AllenXu-weihao/PLFM_RADAR/(commit log)

2026-04-22 chore(fpga): untrack TB-generated CSV, ignore a.out
    rx_final_doppler_out.csv is written by tb_radar_receiver_final.v on
    every run via $fopen — it is a test-run artifact, not an oracle. It
    was mistakenly tracked in an earlier commit, causing unnecessary
    churn on every sim. Remove from the index and ignore going forward.
    Also ignore stray a.out from iverilog one-shot compiles.
    Golden references (.hex, .mem, doppler_golden_py_*.csv) remain
    tracked — they are load-bearing oracles used by MF / Doppler /
    receiver cosim testbenches.
    [rx_final_doppler_out.csv]
2026-04-23 fix(radar): RX chain corrections, GUI bin alignment, MCU boot ordering
    FPGA — RX chain
    matched_filter_multi_segment.v: drop the gratuitous /4 scaling on
    DDC sign-extended input (was ddc_i[17:2] + ddc_i[1]); use
    ddc_i[15:0] directly. fft_engine has INTERNAL_W=32 with
    saturating 16-bit output, so full 16-bit input is safe. Restores
    ~12 dB of MF input dynamic range.
    radar_receiver_final.v: remove latency_buffer (count-N-pulses-then-
    prime FIFO that left frame 1 with all-zero ref). Replaced with
    a single-FF alignment register on ref_i/ref_q that matches the
    1-FF stage multi_segment ST_PROCESSING uses on adc_data.
    Verified by tb/tb_rxb_fullchain_latency.v —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
    [USBHandler.cpp, cfar_ca.v, doppler_processor.v, main.cpp, matched_filter_multi_segment.v, matched_filter_processing_chain.v, models.py]
2026-04-23 feat(fpga): swap matched-filter chain to Xilinx LogiCORE FFT v9.1 IP
    Replaces the in-house iterative fft_engine.v in the matched-filter chain
    with the Pipelined Streaming Xilinx FFT IP, closing RX-NEW-3 (FFT chain
    ~11x too slow vs PRI budget).
    Components:
    * ip/xfft_2048_ip/xfft_2048_ip.xci — committed IP definition
    (16-bit fixed point, BFP scaling, convergent rounding, natural order,
    pipelined-streaming, BRAM data/reorder/phase factors). Vivado
    regenerates .dcp / sim-netlist from this on each build.
    * scripts/50t/gen_xfft_2048_ip.tcl — IP-Catalog generation script
    * scripts/50t/run_xfft_xsim.sh — XSim batch runner for tb_xfft_2048_xsim
    * xfft_2048.v — AXI-Stream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
    [fft_engine_axi_bridge.v, matched_filter_processing_chain.v, tb_xfft_2048_xsim.v, xfft_2048.v]
2026-04-27 fix(mcu): MCU-N5/C4 — runRadarPulseSequence stops shadowing m/n/y globals
    runRadarPulseSequence was redeclaring `int m, n, y` at function scope,
    which shadowed the file-scope `uint8_t m, n, y` globals at lines
    ~190-192 that getStatusString reports to the GUI as
    BeamPos|Azimuth|ChirpCount. The function's increments updated only the
    locals, then discarded them — so telemetry was permanently frozen at
    "BeamPos:1|Azimuth:1|ChirpCount:1" no matter how many beam positions
    or revolutions had elapsed.
    Fix: drop the three local declarations; the body already references
    m/n/y by name, so removing the locals lets the writes hit the globals.
    A comment documents the pitfall so the locals do not get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
    [main.cpp, test_bug16_runradar_shadows_globals.c]
2026-04-27 fix(mcu): MCU-A7 — persist emergency state across MCU resets in BKPSRAM
    Emergency_Stop's hold loop refreshed IWDG forever, so any reset path that
    DID fire (SYSRESETREQ from another fault, brown-out) would re-run
    startup and re-energize the PA rails — there was no record that the
    system had been in emergency state. Watchdog defeat in the hold loop
    masked the problem.
    BKPSRAM gives us a flag that survives every reset path but is lost on
    main-power removal — exactly the recovery semantics we want:
    power-cycle is the deliberate operator action that clears emergency,
    every other reset stays in safe-hold.
    - Added emergency_persist_set/check helpers (BKPSRAM @ 0x40024000,
    magic 0xDEAD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
    [main.cpp, test_mcu_a7_emergency_persist.c]
2026-04-28 fix(mcu): MCU-A2 — site-configurable mag declination, persisted in BKPSRAM
    The magnetometer yaw correction used a hardcoded -0.61 deg literal baked
    in for one deployment site. Yaw_Sensor was wrong by (site_decl + 0.61)
    deg at every other site whenever the UM982 dual-antenna heading was
    unavailable.
    Backed the value with BKPSRAM (slots 1+2 — slot 0 is the MCU-A7
    emergency flag) and exposed set_mag_declination_deg / get_mag_declination_deg.
    Default returns the legacy -0.61 deg when no override has been written so
    the original site stays correct out of the box; a host command (or
    future GPS-derived auto-calibration) writes the new site value once and
    it persists across every reset path unt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
    [main.cpp, test_mcu_a2_mag_declination.c]
2026-04-28 fix(mcu): MCU-A4 — BKPSRAM warm-restart bypass for OCXO 180 s warmup
    Every boot waited the full 180 s OCXO warmup soak — even an
    IWDG/SYSRESETREQ reset that takes seconds and leaves the OCXO oven hot
    lost three minutes of bringup time.
    Added BKPSRAM slot 3 (magic 0xCA1C1F1E) with warmup_persist_set/check
    helpers next to the existing MCU-A2/A7 BKPSRAM block. Cold-boot path
    now arms the flag at the end of the full 180 s soak; subsequent boots
    that find the flag still set know the OCXO oven is still hot and the
    crystal is settled, so they wait 5 s and move on. Power-cycle clears
    BKPSRAM and forces the full soak again — safe default, operator can't
    accidentally skip the warmup by yanking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
    [main.cpp, test_mcu_a4_ocxo_warm_restart.c]
2026-04-28 chore: delete dead latency_buffer; doc cleanup for two stale comments
    latency_buffer.v has had zero non-tb instantiations since RX-B (2026-04-23)
    replaced its hookup in radar_receiver_final with a 1-FF alignment register.
    The module was being kept "for potential future use" — exactly the kind of
    dead weight the codebase does not need. Deleted, along with all build /
    test infrastructure that dragged it along:
    - 9_Firmware/9_2_FPGA/latency_buffer.v
    - 9_Firmware/9_2_FPGA/tb/tb_latency_buffer.v
    - run_regression.sh: removed from RTL_FILES and RECEIVER_RTL
    - scripts/200t/build_200t.tcl: removed from synthesis source list
    - tb/tb_system_e2e.v: removed from header compile-string example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
    [models.py, tb_system_e2e.v, validate_mem_files.py]
2026-04-29 fix(fpga): TX-I — align matched-filter reference with actual post-DDC band
    The DAC short/long chirp LUTs are 10..30 MHz upchirps (Hilbert-confirmed).
    With TX_LO=10.500 GHz, RX_LO=10.380 GHz (adf4382a_manager.h) and the
    120 MHz DDC NCO (ddc_400m.v), high-side mixing places the post-DDC echo
    at 10..30 MHz baseband. The matched-filter reference (gen_chirp_mem.py)
    was generating 0..20 MHz, implicitly assuming the chirp's low edge mixed
    to DC. This caused a 10 MHz spectral offset and ~5 dB matched-filter loss.
    Adds F_BASEBAND_LOW=10e6 in both gen_chirp_mem.py and radar_scene.py,
    with phase formula 2*pi*F_BASEBAND_LOW*t + pi*rate*t^2 in all chirp
    generators. Regenerates the 6 .mem files. Adds a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
    [analyze_short_chirp_mismatch.py, gen_chirp_mem.py, radar_scene.py]
2026-04-29 test(fpga): receiver-integration — fix tb wiring + skip-guard XSim-only checks
    tb_radar_receiver_final had three pre-existing issues that all surfaced as
    fails in regression (32 passed, 2 failed before; 34 passed, 0 after):
    1. host_range_mode was undriven (floating 2'bzz); rmc log confirmed
    "Auto-scan starting, range_mode=z". Add explicit 2'b01 (long-range
    dual-chirp) for the test scenario.
    2. DDC_MAX_ENERGY threshold (2^56) was sized for an unspecified earlier
    stimulus; the test feeds a deliberately-loud 120 MHz sawtooth that
    produces ~1.27e17 energy over 2M samples. Raised to 2^60 (~10x
    observed) so B1b catches true overflow without false-firing.
    3. The 9 doppler-frame-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
    [tb_radar_receiver_final.v]
2026-04-29 doppler: gate S_IDLE→S_ACCUMULATE on frame_start_pulse (AUDIT-S3)
    Pre-fix S_IDLE had two independent if-branches: one for frame_start_pulse
    (resets pointers) and one for data_valid (transitions to S_ACCUMULATE).
    A data_valid arriving before frame_start_pulse would advance the FSM with
    whatever pointers happened to be live, and the BRAM write block would write
    the sample into mem_write_addr = (write_chirp_index*RANGE_BINS) + 0.
    In current operation the race is benign — end-of-S_ACCUMULATE always zeros
    write_chirp_index/write_range_bin (line 287-288) and the MF pipeline latency
    (~165 µs) is millions of cycles longer than the frame_start CDC latency
    (~50 ns), so frame_start always arrives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
    [doppler_processor.v, tb_doppler_frame_start_gate.v]
2026-04-29 mcu(bmp180): replace in-band sentinel + fix uint16->int16 narrowing (AUDIT-C17)
    BMP180_ERROR=255 was an in-band sentinel returned by uint16_t I/O helpers
    (read16, readRawTemperature) on I2C failure. 255 is also a valid uint16
    register reading (0x00FF appears across the calibration block and is
    reachable as a raw temperature/pressure sample), so a sensor failure was
    indistinguishable from a real reading.
    getTemperature() additionally narrowed the uint16_t raw read to int16_t
    before passing to computeB5(). Raw bit-patterns >= 0x8000 (reachable across
    the BMP180 -40..+85 C operating window) flipped to negative int16_t and
    sign-extended into computeB5(), producing temperature errors of order
    10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
    [BMP180.cpp, BMP180.h, test_audit_c17_bmp180_sentinel_and_cast.c]
2026-04-29 fpga: split gpio_dig5/dig7 by fault class (AUDIT-S10)
    gpio_dig5 (PD13) previously OR'd six flags — four signal-saturation
    classes (AGC, DDC overflow, DDC saturation, MTI saturation) and two
    control-fault classes (range-decimator watchdog from F-6.4, CIC->FIR
    CDC overrun from F-1.2). The MCU outer-loop AGC reduces RF gain on
    PD13 assertion, which is the wrong response to a watchdog or CDC
    stall — it just hides the stall behind a quiet receive chain. gpio_dig7
    (PD15) was tied 1'b0 as "reserved".
    Split:
    gpio_dig5 = signal-saturation only (AGC continues to react correctly)
    gpio_dig7 = control-fault classes
    Telemetry: status_words[5][6:5] now exposes the two control-fault
    classes in BOT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
    [radar_system_top.v, radar_system_top_te0713_umft601x_dev.v, tb_audit_s10_gpio_split.v, tb_ft2232h_frame_drop.v, tb_usb_data_interface.v, usb_data_interface.v, usb_data_interface_ft2232h.v]
2026-04-30 AUDIT-S12: parameterize output_bin_count zero-literals in range_bin_decimator
    `output_bin_count` is declared `reg [RP_RANGE_BIN_WIDTH_MAX-1:0]`
    (9 bits on 50T, 12 bits on 200T), but the reset and ST_IDLE assignments
    used the literal `9'd0`. Vivado zero-extends with a width-mismatch
    warning on 200T. The FORMAL port `fv_output_bin_count` was also
    hardcoded `[8:0]`.
    Replace all three sites with `{RP_RANGE_BIN_WIDTH_MAX{1'b0}}` /
    parameterized port width — same pattern already used for the
    `range_bin_index` reset in this module.
    No functional change. Verified by full FPGA regression: 41/41 PASS,
    0 lint errors (Range Bin Decimator: 63 checks PASS).
    [range_bin_decimator.v]
2026-04-30 chirp-v2 PR-F: doppler/CFAR widen to 3 sub-frames + 2-class detect
    Bumps RP_CHIRPS_PER_FRAME 32 -> 48 (= 3 sub-frames × 16 chirps), widens
    doppler_bin from 5 to 6 bits ({sub_frame[1:0], bin[3:0]}), and replaces the
    1-bit detect_flag rail with a 2-bit detect_class (NONE / CANDIDATE /
    CONFIRMED) sourced from a soft+confirm CFAR threshold pair.
    doppler_processor:
    Generalised the 2-subframe FSM to NUM_SUBFRAMES = CHIRPS_PER_FRAME /
    CHIRPS_PER_SUBFRAME (=3 in production, =2 when TBs override). S_OUTPUT
    walks current_sub_frame 0..NUM_SUBFRAMES-1 then advances range_bin;
    the chirp_base * CHIRPS_PER_SUBFRAME formula replaces the if/else split.
    write_chirp_index, read_doppler_index, sub_f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
    [cfar_ca.v, doppler_processor.v, radar_receiver_final.v, radar_system_top.v, radar_system_top_50t.v, tb_cfar_ca.v, tb_doppler_realdata.v, tb_fullchain_realdata.v]
2026-05-01 chirp-v2 PR-G: header/body consistency + runtime MEDIUM ladder
    G1.5 (FSM trim): doppler section emits NUM_RANGE_BINS*NUM_DOPPLER_BINS
    cells (49152 B) and detect emits packed valid bytes (6144 B), matching
    the 9-byte header advertisement. Replaces flat counters with nested
    range x doppler indices in usb_data_interface_ft2232h.v. Saves ~18.4 kB
    per frame on the wire.
    G2 (runtime MEDIUM ladder): adds opcodes 0x17/0x18 for medium chirp/
    listen cycles with RP_DEF_MEDIUM_* defaults. Plumbed through
    radar_system_top -> radar_receiver_final -> chirp_scheduler. SHORT/LONG
    were already runtime-tunable; MEDIUM was hardcoded.
    TBs: tb_usb_protocol_v2 adds TEST 4 (full-frame egress byte count =
    56330) a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
    [radar_receiver_final.v, radar_system_top.v, tb_ft2232h_frame_drop.v, tb_usb_protocol_v2.v, usb_data_interface_ft2232h.v]
2026-05-01 test(mechanics): PR-I.2 — tb_system_mechanics for chirp/RF/safety/CDC
    New TB carving G1 (reset & init), G2 (TX chain — minus G2.2 which lives
    in dataflow), G3 (safety architecture), G7.1 (rapid chirp toggle CDC),
    and G7.3 (TX chirp counter CDC) out of tb_system_e2e into a fast,
    focused subsuite. radar_system_top instantiated with USB_MODE=1
    (production FT2232H path).
    These tests don't need 48-chirp Doppler accumulation, so the sim
    budget is ~80 us of stimulus + observation. Watchdog at 1.5 ms.
    15/15 PASS. Pairs with tb_system_opcodes (commit 413a01e) to cover
    ~half of what tb_system_e2e exercised; the heavy data-flow / reset-
    recovery groups (G2.2, G4, G5, G8, G9) move to tb_system_dat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
    [tb_system_mechanics.v]
2026-05-01 test(dataflow): PR-I.3 — tb_system_dataflow shallow integration probe
    Shallow probe verifying that auto-scan kicks the production pipeline
    end-of-TX-side cleanly: chirp_scheduler emits new_chirp_frame, the
    range pipeline (DDC + matched filter + range decimator) emits
    multi-bin range profiles. Recovers G2.2 (new_chirp_frame pulse),
    G4.1 (range_valid pulse), G4.2 (>=100 range bins) — three of T-2's
    sixteen hidden failures.
    Sim runs ~18 ms simulated (about 60-90 s wall on iverilog) — covers
    one full 48-chirp frame TX time. Watchdog at 25 ms.
    Deferred to PR-J:
    G4.4 doppler_valid pulse, G5.1-5.4 USB egress, G9.x reset recovery.
    Real finding: matched_filter_multi_segment hangs in ST_WA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
    [tb_system_dataflow.v]
2026-05-01 test(realdata): PR-K — synthetic regen of doppler/fullchain realdata fixtures
    Replaces the legacy ADI CN0566 .npy capture flow with a synthetic radar
    scene generated by tb/cosim/real_data/gen_realdata_hex.py via the
    existing radar_scene + fpga_model bit-accurate Python models.
    Dimensions now match production radar_params.vh:
    RP_FFT_SIZE=2048, RP_DECIMATION_FACTOR=4, RP_NUM_RANGE_BINS=512,
    CHIRPS_PER_FRAME=48, NUM_DOPPLER_BINS=48 (3 sub-frames x 16-pt FFT).
    Previously both TBs were pinned to legacy 32-chirp / 2-subframe / 1024->64
    DECIM=16 dimensions. range_bin_decimator.v's 2-bit comparisons against
    DECIMATION_FACTOR/2 only behave correctly for small DECIM, so the old
    DECIM=16 path n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
    [tb_doppler_realdata.v, tb_fullchain_realdata.v]
2026-05-02 fix(fpga): PR-O.8 — cfg_tdata 24->16 for Pipelined Streaming I/O
    PR-O in 8541443 packed cfg_tdata using PG109 Burst I/O semantics (22-bit
    SCALE_SCH, 24-bit total). The xfft_2048 IP we instantiate is Pipelined
    Streaming I/O — that arch has SCALE_SCH width = 2*ceil(NFFT_MAX/2) = 12
    bits, cfg_tdata = 16 bits. Mismatch surfaced when the Vivado-regenerated
    .xci reported C_S_AXIS_CONFIG_TDATA_WIDTH=16. Realigns wrappers + TBs.
    Total /N scaling preserved: 22'h155555 (/N as 11 stages of >>1) becomes
    12'hAA9 (stage 1 alone >>1 + stages 2-11 grouped as 5 pairs of >>2 each).
    Iverilog fft_engine.v fallback unchanged — applies fixed >>>1 per stage.
    Verified: tb_fft_engine_axi_bridge 4/4, tb_match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
    [fft_engine_axi_bridge.v, tb_fft_engine_axi_bridge.v, tb_xfft_2048_xsim.v, xfft_2048.v]
2026-05-02 fix(gui): software_fpga revival post-e8b495c — port chain helpers to fpga_model
    Restore SoftwareFPGA's process_chirps() pipeline by porting the missing
    chain stages (MTI canceller, DC notch, CFAR, threshold detection) plus
    thin wrappers (range FFT, decimator, Doppler FFT) to fpga_model.py and
    swapping software_fpga.py's import target from the deleted
    golden_reference.py to fpga_model.
    History: golden_reference.py was deleted in e8b495c (the "dead golden
    code cleanup") but software_fpga.py kept importing from it. The
    ImportError was swallowed at v7/__init__.py:49-52 so package load
    succeeded, but every direct `from v7.software_fpga import SoftwareFPGA`
    hit the import-time failure — mask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
    [fpga_model.py, software_fpga.py]
2026-05-02 fix(gui): P-2/P-3 — bulk-frame parser + status packet caught up to PR-G v2
    Audit P-2 and P-3 (2026-05-02): GUI radar_protocol.py was still on the
    pre-PR-G wire format. Production frames were rejected 100% before they
    reached the dashboard.
    Bulk frame (P-2):
    - BULK_FRAME_HEADER_SIZE 8 -> 9 (FPGA emits byte[1] = RP_USB_PROTOCOL_VERSION
    = 0x02). All field offsets shift by 1 (frame_num at +3,+4; n_range at
    +5,+6; n_doppler at +7,+8). Parser now validates the version byte.
    - Detect packing: 1 bit/cell (np.unpackbits) -> 2 bits/cell, 4 cells per
    byte MSB-first per PR-F. BULK_DETECT_DENSE_BYTES 3072 -> 6144 (= 512 *
    ceil(48*2/8)). New _unpack_detect_2bit returns uint8 codes 0..3
    (NONE/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
2026-05-02 feat(gui): M-1 / PR-Q.7 — dashboard CRT confidence column + alias-fold tooltip (C-5)
    The CRT extractor (PR-Q.5/PR-Q.6) tags every target with a velocity_confidence
    ("CONFIRMED" / "LIKELY" / "AMBIGUOUS" / "UNKNOWN") and an optional alias_set
    of candidate v_true folds. Until now the operator-facing targets table on the
    Main View tab dropped that signal, so a single-PRI-only AMBIGUOUS reading
    looked identical to a 3-PRI CONFIRMED one.
    Changes:
    - Targets table column count 5 -> 6; new "Confidence" column between
    Velocity and Magnitude.
    - Module helper _confidence_display(label) -> (text, QColor):
    CONFIRMED green (DARK_SUCCESS)
    LIKELY amber (DARK_WARNING)
    AMBIG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
2026-05-05 chore(mcu): PR-W F-6.1 — prune dead ADAR1000Manager surface
    Stage-6 ADTR1107 audit cleanup. Delete 4 unused public methods plus
    their 2 internal helpers from ADAR1000_Manager.cpp/h. Production boot
    goes through main.cpp's C-style systemPowerUpSequence(), so the C++
    ADAR1000Manager::powerUpSystem / powerDownSystem / switchToTXMode /
    switchToRXMode wrappers had zero call sites; the same was true of the
    setPABias / setLNABias helpers, only ever invoked from the dead
    switchTo* paths. -130 LOC, no behavioral change.
    kPaBiasRxSafe is intentionally KEPT — it is live-used inside
    setADTR1107Mode(RX) as the safe PA bias when transitioning to RX.
2026-05-05 docs(fpga): PR-X.2 F-7.3 — refresh tb_ad9484_xsim header + retire Group 4
    Header (line 6, 11): "(IBUFDS, BUFG, IDDR)" → "(IBUFDS, BUFIO, BUFG,
    MMCME2_ADV)"; "IDDR Q2 (falling-edge) data capture in
    SAME_EDGE_PIPELINED mode" → "Falling-DCO-edge IOB-packed IFF capture
    (post-AUDIT-C4 SDR shape; no IDDR, no rise/fall demux)".
    $display banner: "(IBUFDS, BUFG, IDDR)" → "(IBUFDS, BUFIO, BUFG, MMCME2)".
    Group 8 inline comment: "captures Q2 of the IDDR (falling-edge…)"
    → "captures the IOB-packed IFF on the falling DCO edge".
    Test Group 4 retired. The block drove 0xAA on rising DCO and 0x55 on
    falling DCO. Post-AUDIT-C4 the IFF only samples the falling edge —
    every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
2026-05-05 fix(fpga): PR-Y.1 + PR-X.3 — DC notch boundary, audit cleanups, formal retarget
    Bundles audit items unblocked by the AERIS-10 end-to-end audit:
    S-1 (radar_system_top.v) — DC notch off-by-one at width=7
    Audit S-1: ±W around DC in a 16-bin FFT covers bins {0..W, 16-W..15}
    (2W+1 total, bin 8 the only one excluded at W=7). The previous form
    `< W || > 15-W+1` missed both boundaries: at W=1 it notched only {0}
    (skipping 1 and 15); at W=7 it missed 7 and 9. Replaced with inclusive
    comparators against 5-bit limits (`<= notch_lo || >= notch_hi`) which
    hit the intended set for all W ∈ {1..7}. Cosim DC golden
    (tb/cosim/rtl_bb_dc.csv) regenerated against the corrected behaviour.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
    [rtl_bb_dc.csv]
2026-05-07 fix(gui): PR-AB.b follow-up — settings note style, badge spacing, header padding, AGC strip colours
    Cleanup of the four cosmetic items flagged in the PR-AB.b layout audit:
    - Settings tab: the "Host-Side Signal Processing" group note used DARK_WARNING
    (orange) but is purely explanatory, not a caution — converted to italic
    DARK_INFO (blue) so it matches the equally-informational Bench-mode note
    in the next group.
    - AGC group ALWAYS-ON badge: added margin-bottom so it reads as a header
    rather than sitting flush against the first AGC Target row.
    - Detected Targets table: "Velocity (m/s)" header was clipping its leading
    V against the column divider under Stretch resize mode (column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
    [dashboard.py]
2026-05-11 PR-AB.b expanded commit 1: RTL strip (dead modes + counters + range_mode)
    Flatten chirp_scheduler.v to single-FSM auto-scan. Mode 00 (STM32 pass-through),
    mode 10 (single-chirp debug) and mode 11 (track dwell) FSM branches were all
    half-implemented and unreachable in production: MCU dispatcher was deleted in
    F-2.1; mode 11 inputs were tied to constants in radar_receiver_final; mode 10
    debug_wave_sel was hardcoded to SHORT. The case-switch wrapper, watchdog,
    effective_mode mux, and all host_track_* / host_debug_wave_sel / host_trigger
    plumbing are removed.
    Strip host_radar_mode (opcode 0x01), host_trigger_pulse (opcode 0x02), and
    host_range_mode (opcode 0x20). The mode register had no consum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
    [chirp_scheduler.v, plfm_chirp_controller_v2.v, radar_receiver_final.v, radar_system_top.v, radar_system_top_50t.v, radar_system_top_te0713_umft601x_dev.v, radar_transmitter.v, usb_data_interface.v]
2026-05-11 PR-AB.b expanded commit 2: TB cleanup (modes/range/counters strip)
    Restore regression to green after commit 1's RTL strip. Drop dead-signal
    references from 10 TBs to match the post-strip RTL surface:
    - chirp TBs: drop clk_100m / reset_100m_n / new_elevation / new_azimuth
    port wiring on plfm_chirp_controller_v2; drop elevation/azimuth counter
    wires + check() assertions; retire Group 9 (Beam steering counters) in
    tb_chirp_controller and C3 (stm32 toggle non-drive) in tb_chirp_contract.
    - system TBs: drop stm32_new_chirp / stm32_new_elevation / stm32_new_azimuth
    regs + DUT port wiring; drop current_elevation / current_azimuth wires;
    delete stm32_chirp_toggle helper task; retire G6.1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
    [tb_adc_pwdn_opcode.v, tb_chirp_contract.v, tb_chirp_controller.v, tb_e2e_dsp_to_host.v, tb_ft2232h_frame_drop.v, tb_radar_receiver_final.v, tb_system_mechanics.v, tb_system_opcodes.v]
2026-05-18 test(fpga): PR-AD AD.2 — USB driver TB rewrite + cross-comparison parity TB
    tb/tb_usb_data_interface.v was on the obsolete pre-PR-G streaming
    protocol (1-bit cfar_detection, 4-state FSM) — green CI gave false
    confidence because TB and DUT were equally out of date. This rewrite
    exercises the new v2 bulk FSM and adds a cross-comparison TB that
    asserts byte-for-byte equality between the FT601 and FT2232H drivers
    fed identical stimulus.
    tb/tb_usb_data_interface.v — full rewrite (~370 LOC):
    - Mirrors tb_usb_protocol_v2.v test groups for the FT601 path
    - BE-aware byte capture using a single capture_idx integer with
    blocking arithmetic + one non-blocking egress_count update
    (four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
2026-05-18 docs(fpga-xdc): PR-AD.b — close H-1/H-2/H-4 (FT601 XDC documentation rot)
    H-1: ft601_rd_n/ft601_oe_n IOB-packing block claimed "constant-1, USB read
    not implemented" but the driver has had a full RD_OE_ASSERT/READING/DEASSERT
    read FSM since the host-command path was added. Rewrote the comment to
    describe the real FSM-driven traffic and explain that -quiet is now for
    post-synthesis retiming/consolidation cases, not because the registers
    don't exist.
    H-2: production XDC (create_generated_clock ft601_clk_fwd + set_output_delay)
    and FMC dev XDC (set_max_delay -datapath_only) implement two different but
    deliberate timing strategies for the same FT601 output ports — production
    forwards ft601_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
2026-06-17 docs: rewrite README_CN.md with comprehensive Chinese documentation
    Integrate 6 learning notes covering:
    - Hardware architecture (Doc 2-3): power management, frequency synthesizer,
    main board components (DAC/ADC/mixer/phase shifters/PA), antenna arrays,
    peripherals (GPS/IMU/stepper/thermal)
    - Signal processing pipeline (Doc 1,4): 6-step TX→DSP→GUI flow,
    PLFM chirp generation, DDC/CIC/FIR chain, pulse compression
    (overlap-save multi-segment), staggered PRF Doppler, MTI/CFAR,
    hybrid AGC loop
    - Code repository (Doc 5): firmware structure, simulation ecosystem,
    PCB production files, EDA toolchain
    - Licensing (Doc 6): CERN-OHL-P vs MIT dual-license strategy
    Also incorporate FPGA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
